nicholaswilde/solar-battery-charger/docs/assets/images/back-v4.jpg

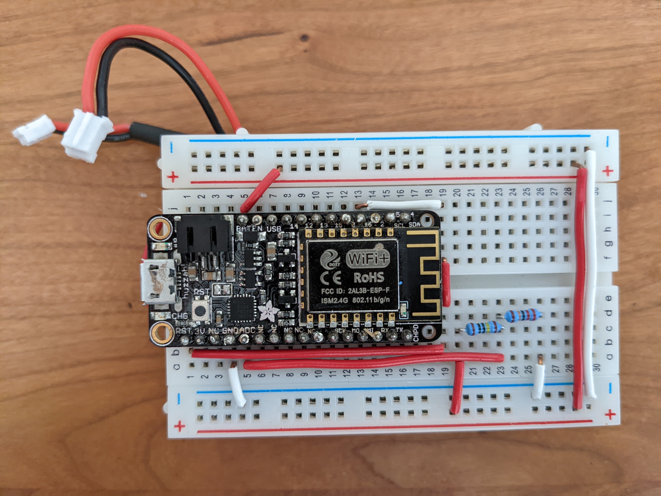
docs/assets/images/back-v4.jpg
