nicholaswilde/solar-battery-charger/docs/assets/images/batteries.jpg

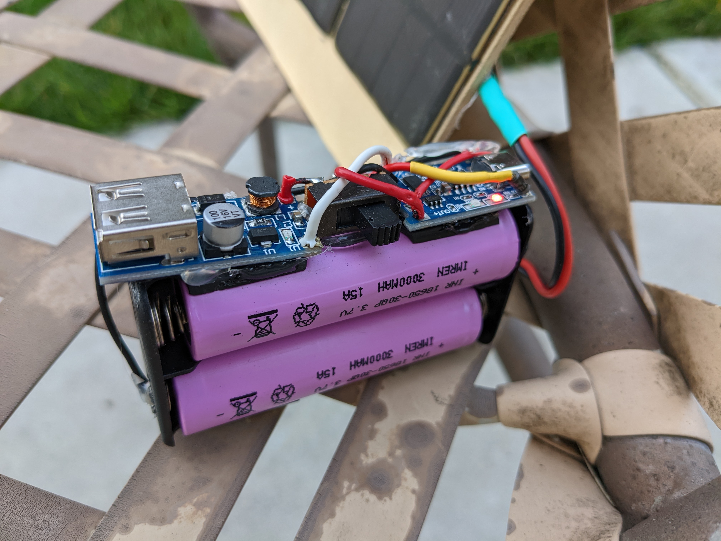
docs/assets/images/batteries.jpg
