nicholaswilde/solar-battery-charger/docs/assets/images/thingspeak-fields.png

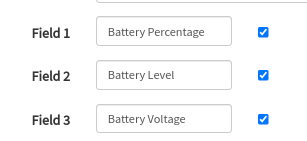
docs/assets/images/thingspeak-fields.png
