nicholaswilde/solar-battery-charger/docs/assets/images/top-v4.jpg

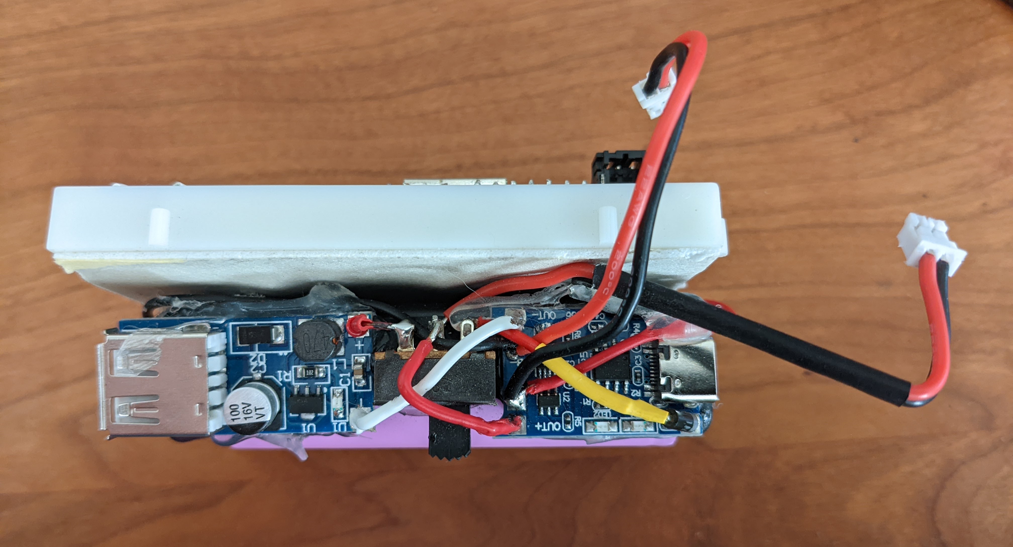
docs/assets/images/top-v4.jpg
