nicholaswilde/solar-battery-charger/test/wake/README.md

# wake

This code displays how to use deep sleep with a touch as a wake up
source and how to store data in RTC memory to use it over reboots.

## Documentation

Documentation can be found [here](https://nicholaswilde.io/solar-battery-charger/test/wake/).
