nicholaswilde/solar-battery-charger/test/ina260/README.md

# ina260

Test the voltage, current, and power readings of the Adafruit INA260 High or Low
Side Voltage, Current, Power Sensor.

## Documentation

Documentation can be found [here](https://nicholaswilde.io/solar-battery-charger/test/ina260/).
