nicholaswilde/solar-battery-charger/test/lbo/README.md

# lbo

WIP

## Documentation

Documentation can be found [here](https://nicholaswilde.io/solar-battery-charger/test/lbo/).
