nicholaswilde/solar-battery-charger/test/powerboost/README.md

# powerboost

WIP

## Documentation

Documentation can be found [here](https://nicholaswilde.io/solar-battery-charger/test/powerboost/).
