nicholaswilde/solar-battery-charger/test/wifimanager/README.md

# wifimanager

A basic test of using the WiFiManager to enter credentials.

## Documentation

Documentation can be found [here](https://nicholaswilde.io/solar-battery-charger/test/wifimanager/).
