nicholaswilde/solar-battery-charger/test/clear/README.md

# clear

Clear a ThingSpeak channel.

## Documentation

Documentation can be found [here](https://nicholaswilde.io/solar-battery-charger/test/clear/).
