nicholaswilde/solar-battery-charger/test/https/README.md

# https

Connect to a secure site and print the response.

## Documentation

Documentation can be found [here](https://nicholaswilde.io/solar-battery-charger/test/https/).
