nicholaswilde/solar-battery-charger/test/pgood/README.md

# pgood

WIP

## Documentation

Documentation can be found [here](https://nicholaswilde.io/solar-battery-charger/test/pgood/).
