nicholaswilde/solar-battery-charger/test/template/README.md

# ${NAME}

WIP

## Documentation

Documentation can be found [here](https://nicholaswilde.io/solar-battery-charger/test/${NAME}/).
