nicholaswilde/solar-battery-charger/test/animation/README.md

# animation

Test the Adafruit 128x64 OLED FeatherWing display with an animation.

## Documentation

Documentation can be found [here](https://nicholaswilde.io/solar-battery-charger/test/animation/).
