nicholaswilde/solar-battery-charger/test/oled/README.md

# oled

Test the Adafruit 128x64 OLED FeatherWing display.

## Documentation

Documentation can be found [here](https://nicholaswilde.io/solar-battery-charger/test/oled/).
