nicholaswilde/solar-battery-charger/test/adjusttime/README.md

# adjusttime

Sketch to verify operation of Timezone library.

## Documentation

Documentation can be found [here](https://nicholaswilde.io/solar-battery-charger/test/adjusttime/).
