nicholaswilde/solar-battery-charger/test/v4/README.md

# v4

Reads value on analog input A0 and calculates
the the percent level of a lipo battery and
upload the value to ThingSpeak.

## Documentation

Documentation can be found [here](https://nicholaswilde.io/solar-battery-charger/test/v4).
