nicholaswilde/solar-battery-charger/test/wifi/README.md

# wifi

A quick wifi test that pings a website.

## Documentation

Documentation can be found [here](https://nicholaswilde.io/solar-battery-charger/test/wifi/).
