nicholaswilde/solar-battery-charger/test/thingspeak/README.md

# thingspeak

Reads value on analog input A0 and calculates the the percent level of a
lipo battery and uploads the value to ThingSpeak.

## Documentation

Documentation can be founder [here](https://nicholaswilde.io/solar-battery-charger/test/thingspeak/).
