nicholaswilde/solar-battery-charger/test/sunset/README.md

# sunset

Get the sunrise and sunset times from a website.

## Documentation

Documentation can be found [here](https://nicholaswilde.io/solar-battery-charger/test/sunset/).
