nicholaswilde/solar-battery-charger/test/sleep/README.md

# sleep

Put the Adafruit Feather Huzzah to a deep sleep.

# Documentation

Documentation can be found [here](https://nicholaswilde.io/solar-battery-charger/test/sleep/).
