nicholaswilde/solar-battery-charger/test/eeprom/README.md

# eeprom

Stores values read from analog input 0 into
the EEPROM. These values will stay in the
EEPROM when the board is turned off and may
be retrieved later by another sketch.

# Documentation

Documentation can be found [here](https://nicholaswilde.io/solar-battery-charger/test/eeprom/).
