nicholaswilde/solar-battery-charger/test/date/README.md

# date

Connect to an NTP server and get the date.

## Documentation

Documentation can be found [here](https://nicholaswilde.io/solar-battery-charger/test/date/).
