nicholaswilde/solar-battery-charger/test/createdat/README.md

# createdat

Get the latest createdAt from ThinkSpeak.

## Documentation

Documentation can be found [here](https://nicholaswilde.io/solar-battery-charger/test/createdat/).
