nicholaswilde/solar-battery-charger/test/comparedates/README.md

# comparedates

Compares the createdAt date from Thingspeak and the current date at UTC.

## Documentation

Documentation can be found [here](https://nicholaswilde.io/solar-battery-charger/test/comparedates/).
