nicholaswilde/solar-battery-charger/test/blink/README.md

# blink

Blink the built in LED without a delay.

## Documentation

Documentation can be found [here](https://nicholaswilde.io/solar-battery-charger/test/blink/).
