nicholaswilde/solar-battery-charger/test/battery/README.md

# battery

Reads value on analog input A0 and calculates the the percent level of a lipo battery.

## Documentation

Documentation can be found [here](https://nicholaswilde.io/solar-battery-charger/test/battery/).
