nicholaswilde/solar-battery-charger/docs/test/https.md

# https

Connect to a secure site and print the response.

## Sketch

The sketch can be found [here][1].

## Hypothesis

WIP

## Assumptions

WIP

## Procedure

### Circuit



Circuit made with [Circuit Diagram][2].

### Code

WIP

### Output

WIP

## Analysis

WIP

## Conclusion

WIP

## References
- https://github.com/mathworks/thingspeak-arduino/blob/4110765fca328faf6abebcc8d7ed3a78ad583c2a/examples/ESP8266/program%20board%20directly/ReadFieldSecure/ReadFieldSe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

[1]: https://github.com/nicholaswilde/solar-battery-charger/tree/main/test/https
[2]: https://www.circuit-diagram.org/
