nicholaswilde/solar-battery-charger/docs/test/animation.md

# animation

Test the Adafruit 128x64 OLED FeatherWing display with an animation.

## Sketch

The sketch can be found [here](https://github.com/nicholaswilde/solar-battery-charger/tree/main/test/animation)

## Hypothesis

WIP

## Assumptions

WIP

## Procedure

WIP

### Circuit

WIP

Circuit made with [Circuit Diagram](https://www.circuit-diagram.org/)

### Code

```shell title="Install Adafruit SH110X library"
arduino-cli lib install "Adafruit SH110X"
```

```shell title="Install Adafruit GFX Library"
arduino-cli lib install "Adafruit GFX Library"
```

### Output

WIP

## Analysis

WIP

## Conclusion

WIP

## References
- https://create.arduino.cc/projecthub/mdraber/create-animation-for-128x32-oled-ssd1306-with-arduino-5cf5f5
- http://adafruit.github.io/Adafruit-GFX-Library/html/index.html
- https://adafruit.github.io/Adafruit_SH110x/html/index.html
- https://javl.github.io/image2cpp/
