nicholaswilde/solar-battery-charger/docs/test/createdat.md

# createdat

Get the latest createdAt from ThinkSpeak.

## Sketch

Sketch can be found [here](https://github.com/nicholaswilde/solar-battery-charger/tree/main/test/createdat).

## Hypothesis

WIP

## Assumptions

WIP

## Procedure

WIP

### Circuit



Circuit made with [Circuit Diagram](https://www.circuit-diagram.org/)

### Code

WIP

### Output

```shell title="Typical Output"
test: createdat
Connecting to SSID: MySSID
...connected
IP Address: 192.168.1.77
Hostname: Feather
2022-02-07
2022-02-07 is newer than 2002-02-02
2022-02-07
2022-02-07 is newer than 2002-02-02
2022-02-07
2022-02-07 is newer than 2002-02-02
```

## Analysis

WIP

## Conclusion

WIP

## References
- https://arduino.stackexchange.com/a/63475
