nicholaswilde/solar-battery-charger/docs/test/comparedates.md

# comparedates

Compares the createdAt date from Thingspeak and the current date at UTC.

## Sketch

The sketch can be found [here](https://github.com/nicholaswilde/solar-battery-charger/tree/main/test/comparedates).

## Hypothesis

WIP

## Assumptions

WIP

## Procedure

WIP

### Circuit



Circuit made with [Circuit Diagram](https://www.circuit-diagram.org/)

### Code

WIP

### Output

```shell title="Typical Output"
test: comparedates
Connecting to SSID: MySSID
.connected
IP Address: 192.168.1.77
Hostname: Feather
Starting UDP
Local port: 8888
Waiting for sync
Transmitting NTP Request
us.pool.ntp.org: 44.190.6.254
Receiving NTP Response
CurrentDate: 2022-02-07
CreatedAt: 2022-02-07
2022-02-07 is the same day as 2022-02-07
going to sleep
```

## Analysis

WIP

## Conclusion

WIP

## References

WIP
