nicholaswilde/solar-battery-charger/docs/test/blink.md

# blink

Blink the built in LED without a delay.

## Sketch

The sketch can be found [here](https://github.com/nicholaswilde/solar-battery-charger/tree/main/test/blink).

## Hypothesis

WIP

## Assumptions

WIP

## Procedure

WIP

### Circuit

Use the built in red LED.



Circuit made with [Circuit Diagram](https://www.circuit-diagram.org/)

### Code

WIP

### Output

The built in red LED blinks continuously for in the specifed interval.

## Analysis

WIP

## Conclusion

WIP

## References
- https://www.arduino.cc/en/Tutorial/BuiltInExamples/BlinkWithoutDelay
