nicholaswilde/solar-battery-charger/test/README.md

# Test

The purpose of these tests is to test each component of the project before integrating them into the overall project.
