nicholaswilde/solar-battery-charger/(threads)

Thread 10 (2022-02-20):

Permanent Circuit Board

nicholaswilde, 2022-02-20:
Convert from using a breadboard to a more permanent board.

nicholaswilde, 2022-02-21:
073419ca058c2a74c1ec1afa4fa083dd260d7d02

Closed 2022-02-21.

Thread 3 (2022-02-20):

bq24074

nicholaswilde, 2022-02-20:
Test the [Adafruit bq24074](https://www.adafruit.com/product/4755) to see if it's a better setup than the [HiLetgo TP4056 Type-C USB 5V 1A 18650 Lithium Battery Charger Module](https://www.amazon.com/gp/product/B07PKND8KG/).

Closed 2022-03-22.

Thread 4 (2022-02-20):

Battery Optimization

nicholaswilde, 2022-02-20:
Optimize the battery setup to ensure that the full battery pack can be charged on an average day in the sun. This will most likely be limited to the solar panel power output.

Thread 7 (2022-02-20):

HUZZAH32 – ESP32 Feather Board

nicholaswilde, 2022-02-20:
Test the [HUZZAH32 – ESP32 Feather Board](https://www.amazon.com/gp/product/B01NCRYHDL/) that has an internal voltage reader and additional analog pins.

Closed 2022-02-22.

Thread 8 (2022-02-20):

ESP32-S2 Feather with BME280 Sensor

nicholaswilde, 2022-02-20:
Test the [ESP32-S2 Feather with BME280 Sensor](https://www.adafruit.com/product/5303) that has a built in temperature and humidity sensor as well as a built in battery voltage meter.

nicholaswilde, 2022-03-24:
Can't seem to connect to it using Linux in my Chromebook. The port shows up as ttyACM0 but disconnects when trying to upload to it which is due to the native USB support.
https://learn.adafruit.com/adafruit-esp32-s2-feather/using-with-arduino-ide

When putting it into ROM bootloader mode, the Chromebook asks to share the USB port with Linux, but doesn't show up in the `/dev` folder.

Thread 19 (2022-02-23):

Update Configuration Page with ESP32

nicholaswilde, 2022-02-23:
Update the [configuration](https://nicholaswilde.io/solar-battery-charger/configuration/) page with ESP32.

Closed 2022-02-24.

Thread 20 (2022-02-23):

Update Design Page

nicholaswilde, 2022-02-23:
Update Design page with the following:
- Warning about boost converter being loose because only being held down by rear two pins.
- Add ESP32 feather to hardware list.

Closed 2022-02-24.

Thread 21 (2022-02-24):

Charge and Discharge Calculations

nicholaswilde, 2022-02-24:
Calculate the charge and discharge times based on the battery size and solar panel voltage.

https://learn.adafruit.com/energy-budgets

Thread 27 (2022-02-27):

Settings.h

nicholaswilde, 2022-02-27:
Breakout settings.h file

nicholaswilde, 2022-03-06:
[ed64988](https://github.com/nicholaswilde/solar-battery-charger/pull/29/commits/ed6498836aa1ede0e302052b537cc1a188f4f477)

Closed 2022-03-06.

Thread 28 (2022-02-28):

PowerBoost 1000 Basic LBO Monitoring

nicholaswilde, 2022-02-28:
When trying to monitor the LBO pin of the PowerBoost 1000 Basic with the ESP32, the red LED comes on and prevents the Feather from booting.
https://forums.adafruit.com/viewtopic.php?f=24&t=156911&p=773904#p773904

nicholaswilde, 2022-03-31:
Won't fix because voltage gets pulled too low too easily when discharging.

Closed 2022-03-31.

Thread 35 (2022-03-09):

Test BatterySense

nicholaswilde, 2022-03-09:
Test [BatterySense](https://github.com/rlogiacco/BatterySense)

nicholaswilde, 2022-03-22:
No longer relevant since voltage divider has been removed.

Closed 2022-03-22.

Thread 36 (2022-03-09):

Schematic Update - Switch to turn off voltage divider

nicholaswilde, 2022-03-09:
Update the schematic with the Feather switch to switch off the voltage divider and not short the `EN` pin on the feather so that the battery can be preserved by not draining through the voltage divider.

nicholaswilde, 2022-03-09:
The back image should also be updated to reflect the new wiring.

nicholaswilde, 2022-03-22:
No longer relevant since voltage divider has been removed.

Closed 2022-03-22.

Thread 37 (2022-03-09):

Test VoltageReference

nicholaswilde, 2022-03-09:
Test [VoltageReference](https://github.com/rlogiacco/VoltageReference)

nicholaswilde, 2022-03-22:
No longer relevant since voltage divider has been removed.

Closed 2022-03-22.

Thread 38 (2022-03-16):

Add Touch Wakeup

nicholaswilde, 2022-03-16:
Add touch wakeup where a button is pressed while in deep sleep and the Feather displays a reading for a short period of time and goes back to sleep without uploading to ThingSpeak.

https://randomnerdtutorials.com/esp32-touch-wake-up-deep-sleep/

Closed 2022-03-22.

Thread 40 (2022-03-16):

Low battery voltage causes low current recharge

nicholaswilde, 2022-03-16:
It is possible for the battery voltage to dip to 1.8 VDC due to the Powerboost and the lack of a battery protection circuit. With this low of a voltage, the charging current becomes very low (~78 mA). Once the battery voltage raises above a threshold (~3 VDC), the charging current increases drastically (~500 mA).

Closed 2022-03-22.

Thread 43 (2022-03-22):

bq24074 Dies Randomly

nicholaswilde, 2022-03-22:
I've gone through two bq24074 to where it just stops charging the battery. Monitoring the `LIPO` pin, the voltage oscillates between 0 and 4VDC. I suspect that it is because the panel is outputting more than 1A thus frying the IC. I have since cut the 1A jumper and soldered the 1.5A. This needs to be verified by reading the current of the panel.

Thread 44 (2022-03-22):

Calibration

nicholaswilde, 2022-03-22:
Add a calibration page to calibrate the battery capacities. Coulomb counting may be used for this calibration.

Closed 2022-04-03.

Thread 46 (2022-03-22):

Permanent Board Design

nicholaswilde, 2022-03-22:
A permanent board design should be implemented instead of using a breadboard. Look at KiCAD and PCBWay to design and build the board like the [Sensor Playground project](https://hackaday.io/project/182619-sensor-playground).

Thread 50 (2022-03-23):

Go to sleep while charging with button press

nicholaswilde, 2022-03-23:
When button `A` is pressed while charging, the screen turns on. However, the Feather can't go back to sleep without resetting the Feather all together which will also upload a new data point to ThingSpeak. See if the button press when the display is on and charging can put the Feather back to sleep without resetting and sleep for the time remaining in order to keep the upload interval the same.

Closed 2022-04-02.
