nicholaswilde/solar-battery-charger/test/animation/animation.ino

/*--------------------------------------------------------------
  Program:      animation

  Description:  Test the Adafruit 128x64 OLED FeatherWing
                display with an animation

  Hardware:     Adafruit Feather Huzzah with Adafruit 128x64
                OLED FeatherWing

  Software:     Developed using arduino-cli 0.21.0.

  Date:         09FEB2022

  Author:       Nicholas Wilde 0x08b7d7a3
--------------------------------------------------------------*/

#include <SPI.h>
#include <Wire.h>
#include <Adafruit_GFX.h>
#include <Adafruit_SH110X.h>

#define SCREEN_WIDTH 128 // OLED display width, in pixels
#define SCREEN_HEIGHT 64 // OLED display height, in pixels

Adafruit_SH1107 display = Adafruit_SH1107(SCREEN_HEIGHT, SCREEN_WIDTH, &Wire);

// interval between the animation frames
int frame_delay = 420;

const int16_t width = 80;
const int16_t height = 32;

const int16_t x = (SCREEN_WIDTH-width)/2;
const int16_t y = (SCREEN_HEIGHT-height)/2;

const unsigned char Frame1 [] PROGMEM = {
  0x00, 0x00, 0x00, 0x00, 0x00, 0x00, 0x00, 0x00, 0x00, 0x00, 0x00, 0x00, 0x00, 0x00, 0x00, 0x00, 
  0x00, 0x00, 0x00, 0x00, 0x00, 0x00, 0x00, 0x00, 0x00, 0x00, 0x00, 0x00, 0x00, 0x00, 0x00, 0x00, 
  0x00, 0x00, 0x00, 0x00, 0x00, 0x00, 0x00, 0x00, 0x00, 0x00, 0x00, 0x00, 0x00, 0x00, 0x00, 0x00, 
  0x00, 0x00, 0x00, 0x00, 0x00, 0x00, 0x00, 0x00, 0x00, 0x00, 0x00, 0x00, 0x00, 0x00, 0x00, 0x00, 
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
    showFrame(frames[i]);
  }
  if (frame_delay>100) frame_delay=frame_delay-50;
}

void showFrame(const unsigned char* frame){
  display.clearDisplay();
  display.drawBitmap(x,y,frame, width, height, 1);
  display.display();
  delay(frame_delay);
}
