nicholaswilde/solar-battery-charger/(commit log)

2022-01-24 Move sketches to test folder and rename arduino_secrets.h to secrets.h
2022-01-26 Add circuit image
2022-01-27 Change resistance
2022-01-27 Remove circuit.png
2022-01-29 Add diode
2022-01-30 Update circuit
2022-01-30 Add blink of LED on connect, hostname
2022-02-02 Added battery percentage
2022-02-02 Add BOARD variable
2022-02-02 Add BOARD to vars task
2022-02-04 Change min voltage
2022-02-05 Add pin 16 jumper
2022-02-06 Add note for battery wiring in parallel
2022-02-07 Add second battery
2022-02-07 Update circuit layout
2022-02-07 Update series wiring
2022-02-07 Fix circuit image
2022-02-07 Add board
2022-02-07 Add adafruit ESP32
2022-02-12 Remove link to missing circuit image
2022-02-14 Update B+ pin
2022-02-18 Add user api key and SHA1 fingerprint
2022-02-18 Add user api key and get-fingerprint
2022-02-20 Remove fingerprint and add Clear Channel section
2022-02-20 Comment out fingerprint
2022-02-21 Add arduino-lint
2022-02-21 Add yamllint, pre-commit, and arduino-lint
2022-02-21 Update BOM
2022-02-21 Update charger image to v0.7.0
2022-02-22 Add esp32 core and Time lib
2022-02-22 Add esp32 support
2022-02-23 - Move 15s delay to inside of clearChannal. - Fix ESP32 voltage and percentage calculations.
    [solar-battery-charger.ino]
2022-02-23 Add ESP32 and tabs
2022-02-26 Move battery to own src sketch
2022-02-27 Change ESP32 analog pin to A2 from A0 because ADC 2 on the HUZZAH32 turns off once connected wo WiFi. https://learn.adafruit.com/adafruit-huzzah32-esp32-feather/esp32-faq#faq-2991123 Add voltage divi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
2022-02-27 Add switch to switch between boards
2022-03-08 Add powerboost
2022-03-14 Add switch explainations
2022-03-16 Add wake button
2022-03-20 Add BMS
2022-03-20 Change pin B to A for displaying measurements
2022-03-22 Add missing front panel and update sketch
    [solar-battery-charger.ino]
2022-03-22 Add icon to Battery Holder
2022-03-29 Replace esp32 url with dev version and remove esp8266 url
2022-03-29 Replace esp32 url with dev version
2022-03-30 Fix ClearChannel panic. Remove ESP8266 support.
    [ClearChannel.h]
2022-03-30 Remove Battery.h
2022-03-30 Fix shouldClearChannel bug (#45)
    [ClearChannel.h]
2022-04-02 Add BUTTON_B
2022-04-02 Add sleep during awake charging mode using button B (#50). Change wakup button from button A to B.
2022-04-03 Add params to calculate battery percentage
2022-04-03 Add calibration page and reference to it (#47)
2022-04-03 Remove Created at1 serial print
2022-04-05 Add conditional display if above current threshold (#53)
